ecosensors/EcoBoard/examples/_pyranometer/README.md

# Davis Pyranometer 6450
(This example is being written)

Ref: https://www.meteo-shopping.fr/Station-meteo/Pyranometre-pour-mesure-du-rayonnement-solaire-6450-Davis-Instruments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

The example file is coming.... :)

## Wiring
wire | Pin
--- | ---
Green wire | Output (0 to +3VDC); **1.67 mV per W/m2**
Red & Black wires | Ground
Yellow wire | +3 VDC ±10%; 1mA (typical)
 
Range . . . . . . .  . .	0 to 1800 W/M2

The script is distributed WITHOUT WARRANTY.
Feel free to collaborate and share suggestions for improvement
