ecosensors/EcoBoard/examples/01_bme280/README.md

# BME280
The script is distributed WITHOUT WARRANTY

Feel free to collaborate and share suggestions for improvement

## Libraries

Make sure you have the needed libraries in SKETSCHBOOK/Libraries/

Open Arduino IDE, and then go to **Sketch -> Add Library -> Manage Libraries** 

Search and install

* Adafruit BME280 Library

The library will install other dependencies:

* Adafruit BusIO
* Adafruit Unified Sensor

Close and reopen Arduino IDE

## Wire

Board | BME280
--- | ---
3V3 | VCC
GND | GND
SDA | SDA
SLC | SLC 

Go ahead with the bme280.ino ;)
