ecosensors/EcoBoard/assets/del/charge-rate.jpg

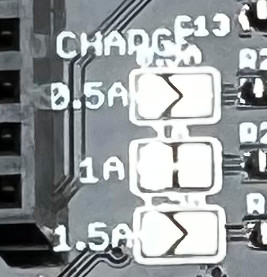
assets/del/charge-rate.jpg
