ecosensors/EcoBoard/assets/del/ecoboard.jpg

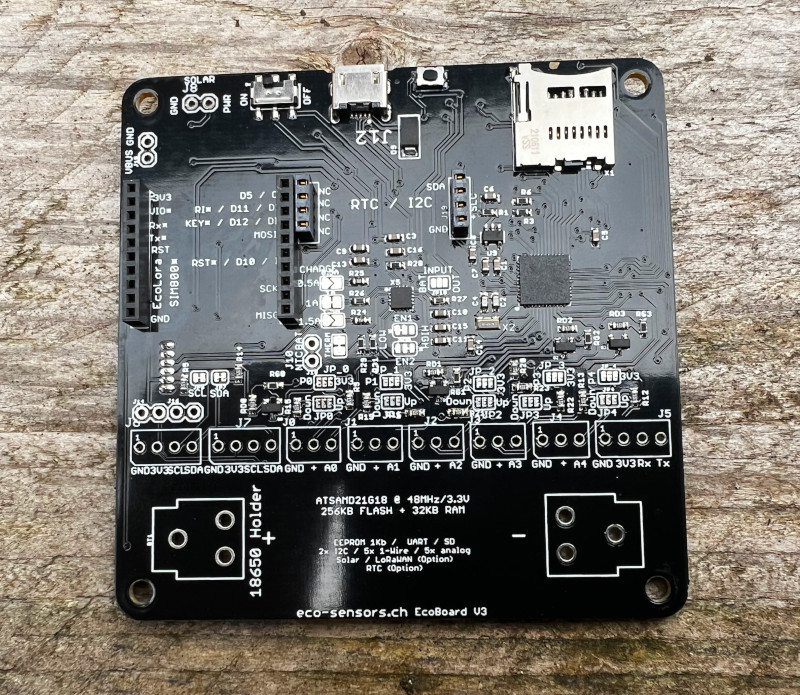
assets/del/ecoboard.jpg
