ecosensors/EcoBoard/assets/del/input-current-limit.jpg

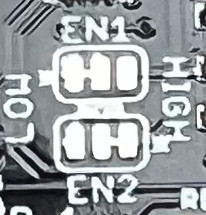
assets/del/input-current-limit.jpg
