ecosensors/EcoBoard/assets/del/j0.jpg

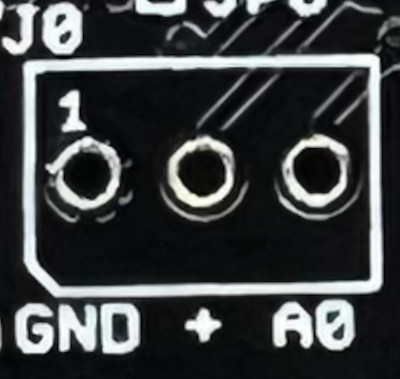
assets/del/j0.jpg
