ecosensors/EcoBoard/assets/del/jp_1.jpg

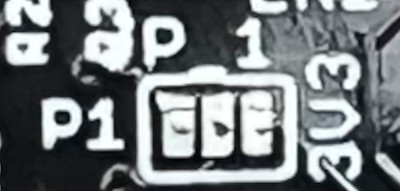
assets/del/jp_1.jpg
