ecosensors/EcoBoard/assets/del/lora.jpg

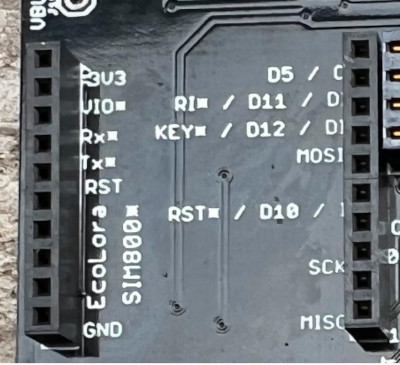
assets/del/lora.jpg
