ecosensors/EcoBoard/assets/del/lorawan-large.jpg

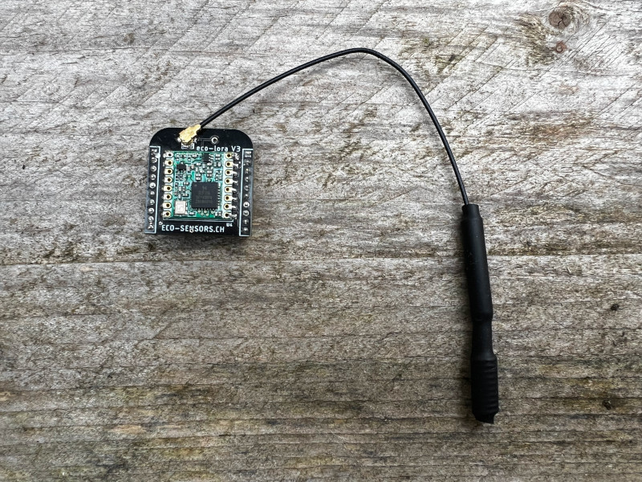
assets/del/lorawan-large.jpg
