ecosensors/EcoBoard/assets/del/mosfet.jpg

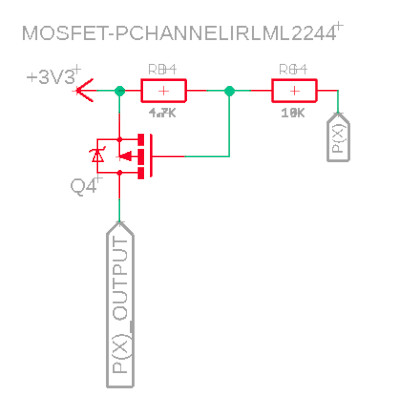
assets/del/mosfet.jpg
