ecosensors/EcoBoard/assets/del/ntc.jpg

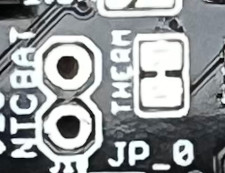
assets/del/ntc.jpg
