ecosensors/EcoBoard/assets/del/pullupdown.jpg

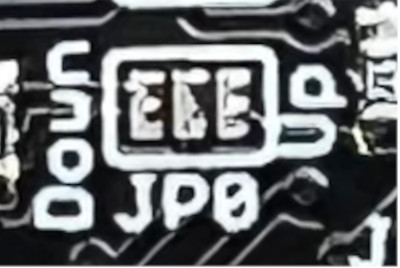
assets/del/pullupdown.jpg
