ecosensors/EcoBoard/assets/EcoBOARDbeta-back.png

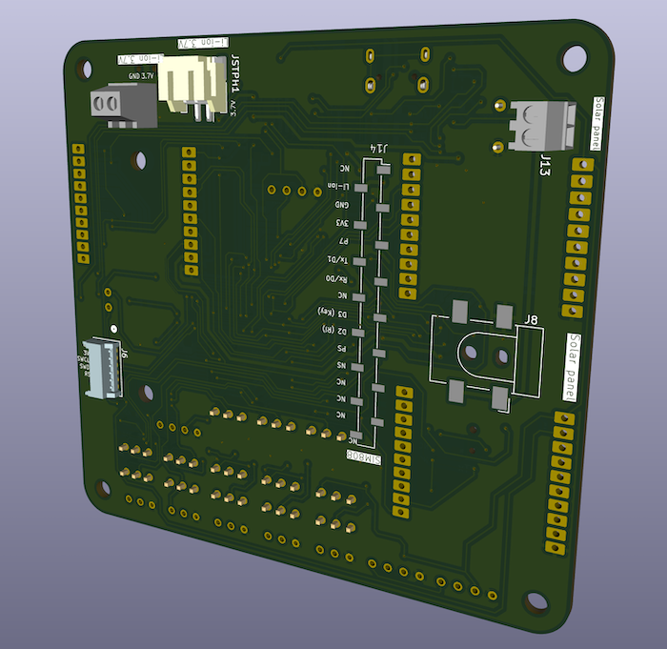
assets/EcoBOARDbeta-back.png
