ecosensors/EcoBoard/examples/expander-1wire/expander-1wire.ino

/*
 * EcoSensors
 * 
 * That file is still a draft
 *
 * WARNING: This script is presented for informational purposes only and no warranty is given as to its suitability for 
 * your environment
 * The script will to be updated and improved following your needs
 *
 * 
 * EXPANDER PORT
 * ===========================================================================
 * This is an example to use PCF8574 (expander port) with the EcoBoard)
 * You can easly use that example for an other application, but the codeand explication below is written for EcoBoard.
 * 
 * EcoBoard allow you to use 6 additonal GPIO with the PCF8574 ([Datasheeet](https://www.ti.com/product/PCF8574). 
 * The outputs P1 to P6, will allow you to control the status of another device or an LED. 
 * However, the outputs can only provide 25mA. In some cases, this power may not be sufficient. 
 * It's the reason why, we added three MOSFET-P (IRML2244) on the outputs P1, P2 and P3. 
 * Thus, the outputs P1, P2 and P3 of the J3 connector can now supply up to 500mA. 
 * The P3, P5 and P6 outputs depend on the PCF8574.
 * 
 * You wil see how to turn on/off the two LED connected to the PCF8574 (p5 & P6)
 * 
 * P4 is used to power the 1-Wire sensor.
 * 
 * 1-Wire SENSOR:
 * ----------------------------------------------------------------------------
 * In that example, we test the DS18B20 sensor (Waterproof temperature sensor)
 * That sensor has 3 wires:
 * 
 * RED : 3V3
 * BLUE : GND
 * YELLOW: READ
 * (Note: Some the color of the sensor are different. Look at the datasheet)
 * 
 * The red wire (POWER) is connected to pin P4 of the PCF8574. It will power the sensor when we need to ake a measure
 * The yellow wire (RED) is connected to A5 of the ATSAM21 microcontroller
 * 
 * You will see below how to use the 1-Wire sensor with EcoBoard
 * (You can use that example for another application, but you will have to modify the pin definition
 * 
 */
#include <Ecoboard.h>
bool isSdEnable = false;            // Disable SD card
Ecoboard Eco(isSdEnable);
#include <Wire.h>                   // Required for I2C communication
#include "PCF8574.h"                // Required for PCF857
PCF8574 expander;                   // Required for PCF857
#include <OneWire.h>                // Requiered for 1-Wire sensor

#define P1 1 // pin P1
#define P2 2 // pin P2
#define P3 3 // pin P3
#define P4 4 // pin P4              // In the example, P4 will be used to power the 1-Wire sensors (DS18B20 sensor)
#define LED5 5 // pin P5
#define LED6 6 // pin P6


// For 1-Wire sensor & DS18B20
float temperature;
const byte ONEWIRE_READ = 19;       // (19 = A5)  A5 will be use to read the DS18B20 sensor value
enum DS18B20_RCODES {               // Status code
  READ_OK,  // Lecture ok
  NO_SENSOR_FOUND,  // Pas de capteur
  INVALID_ADDRESS,  // Adresse reçue invalide
  INVALID_SENSOR  // Capteur invalide (pas un DS18B20)
};
bool reset_search = true;
OneWire ds(ONEWIRE_READ);         // Create OneWire object
  

void setup() {
  Serial.begin(9600);
  Wire.begin();                   // Start I2C

  delay(8000);
  Eco.begin();
  
  Serial.println("     ECOBOARD     ");
  Serial.println("     expander     ");
  Serial.println("------------------");
  Serial.println("");

  Serial.println("Starting with PCF8574");

  expander.begin(0x27);           // Define the I2C address
  expander.pinMode(1,OUTPUT);     // define the pin mode as Output
  expander.pinMode(2,OUTPUT);
  expander.pinMode(3,OUTPUT);
  expander.pinMode(4,OUTPUT);
  expander.pinMode(5,OUTPUT);
  expander.pinMode(6,OUTPUT);

  for(int p=1; p<7;p++){
    expander.digitalWrite(p,LOW);                                   // Set all outputs LOW
    delay(50);
    Serial.print(F("\tP")); Serial.print(p); Serial.print(F(":"));  // Print the output status
    Serial.println(expander.digitalRead(p) ? "HIGH" : "LOW");
    delay(50);
  }

  /*
   * 1Wire sensor
   */
   
}

void loop() {
  Serial.println("TESTING THE LEDs (P5 and P6)");
  Serial.println("Turn on LED 5");
  expander.digitalWrite(LED5, HIGH);
  delay(1000);
  Serial.println("Turn off LED 5");
  expander.digitalWrite(LED5, LOW);
  delay(1000);
  Serial.println("Turn on LED 6");
  expander.digitalWrite(LED6, HIGH);
  delay(1000);
  Serial.println("Turn off LED 6");
  expander.digitalWrite(LED6, LOW);
  delay(1000);
  Serial.println("");

  /*
  * 1-Wire
  */
  Serial.println(F("1-WIRE"));
  Serial.println(F("******************************"));
  Serial.println(F("Power the DS18B20 sensor with P4"));
  expander.digitalWrite(P4,HIGH);
  delay(100);
  Serial.println(F("Read a value from A5"));

  byte data[9], addr[8];
  // data[] : Data read from scratchpad
  // addr[] : Adress of the deteted 1-Wire  
  if (reset_search)                           // Reset the 1-Wire bus (needed for the read of the first sensot)
  {
    ds.reset_search();
  }
  
  if (!ds.search(addr))                       // Serach for next 1-Wire sensor
  {
    expander.digitalWrite(P4,LOW);   // No 1-Wire found, power off DS18B20
    Serial.println(F("No 1-Wire sensor found"));
    //return NO_SENSOR_FOUND;
  }   
      
  if (OneWire::crc8(addr, 7) != addr[7])      // Check the 1-Wire address
  {
    expander.digitalWrite(P4,LOW);   // Address not valid, power off DS18B20   
    Serial.println(F("Address not valid"));
    //return INVALID_ADDRESS;
  }
 
  if (addr[0] != 0x28)                        // Check if the 1-Wire sensor is a DS18B20
  {
    expander.digitalWrite(P4,LOW);   // Wrong sensor, power off DS18B20 
    Serial.println("Wrong sensor");
    //return INVALID_SENSOR;
  }

  ds.reset();                                 // Reset 1-Wire bus
  ds.select(addr);                            // Select the sensor  
  ds.write(0x44, 1);                          // Take a measure and wait the end of the task
  delay(800);
    
  ds.reset();                                 // Reset 1-Wire bus
  ds.select(addr);                            // Select the sensor
  ds.write(0xBE);                             // Request the read of the scraptcha
   
  for (byte i = 0; i < 9; i++)                // Raed the scratchpad
  {
    data[i] = ds.read();
  }
     
  // Calculate the value Celsius 
  temperature = ((data[1] << 8) | data[0]) * 0.0625;
 
  // No erros
  expander.digitalWrite(P4,LOW);      // Power of the 1-Wire sensor 
  Serial.print("Temperature: ");
  Serial.println(temperature);
  // return READ_OK;
  Serial.println("");

}
