ecosensors/EcoBoard/(commit log)

2020-06-22 Create expander-1wire.ino
    How to use the expander port and 1-Wire waterproof temperature sensor (DS18B20) with EcoBoard
2024-07-04 Update _rtc-sd-bme280.ino
    Removing a bug
    [_rtc-sd-bme280.ino]
2024-07-05 Update file
    Correcting a mistake
    [06_rtc-sd-bme280.ino]
2024-07-06 Update 06_rtc-sd-bme280.ino
    Removing defineVolumeWorkingDirectory() function; Solving some bugs
    [06_rtc-sd-bme280.ino]
2024-07-06 Update 06_rtc-sd-bme280.ino
    Small bug
    [06_rtc-sd-bme280.ino]
2024-07-07 Update 06_rtc-sd-bme280.ino
    Adding comments and correcting a small bug
    [06_rtc-sd-bme280.ino]
